ARISEAdaptiveDesign/WildThing-Collaboration/README.md

# Arise_WildThing
Controls for Wild Thing Conversion

2022-08-01 
General statement: continued changes to refine feel at "near straight for/rev"
Changed Mix Tables to 15x2 array (was 14x2 array)
Changed "StraightDwell" to "TrimAngle" - so instead of having "dwell" area close to zero, 
it now has "Trim" zone where subtle left/right will adjust faster/slower on outer/inner wheels
tuning can be made by new calibration TrimPlus and TrimMinus

2022-07-24
General statement: Mix Tuning/Redo

2022-07-21 v4.3 from v4.2
General statement: Configured motor braking for VNH5019
*ARISE_WildThing_MEGA.in0
  - Added handling for motor braking in lines 294 to 309 for both left and right motors of course
  - braking is ramped up at a rate defined by tunable parameter "BrakeRamp"
*CalibrationJoystick.h
  - Added variables BrakeL and BrakeR to keep track of how much to brake
  - Added "BrakeRamp" to control how fast to turn brakes on.

2022-07-17 v4.2 (VNH5019)
General statement: Updated documentation
*moved pulldown resistor from pin 12 to pin 13

2022-07-15 v4.2 (VNH5019) from v4.1
General statement: Needed to remove "bang" when motors change direction, so Added Zero Crossing handling
Details
* Added calibration "zeroCrossingDwell" to tune how long to keep motor off before changing direction
* Add code to ARISE_WildThing_MEGA.ino lines 180-202(ish) to keep motor off if changing direction

2022-07-14 v4.1 (VNH5019) from v4.0
General statement: Made changes to debug mix and re-tune
Details
* Changed debug.ino to allow more information on one page
* Changed Calibrations- Motor Drop Out, Dwells

2022-05-30 v4.0 (VNH5019) from v3.3 (Spark)
General statement: Reset baseline back to VNH5019 and added wiring diagrams
Details
* Added Pull Down Resistors to electrical circuit
* Updated Software with v3.3 features and tuning
* Created Diagram Wiring for Backpack
* Changed Shield wiring from JST connectors to "soldered wire to connector"
* Deleted Green "Running" LED

2022-04-13 v3.3 GT's tuning
We have V3.0 for VNH5019 motor driver, but then made updates in SPARK version (for Grant's machine) to bring up to v3.0 software (with Pot and better tether logic). We then found software improvements for low power settings and made changes (Spin & Turn were updated to have forward vs backward tuning). So we want to merge these changes back to V3.0 for VNH5019 controller.
Also we found signal drift on analog signals (switched and joysticks) so added pulldown resistors back in.

2022-04-11 Debugged wiring and added pulldown resistors to all analog inputs. Setup for SPARK controller configuration

2022-03-21 added the DualVNH5019MotorShield dual motor controller to the list of configurable motor drivers.
The wiring diagram is setup specifically for the DualVNH5019MotorShield but other motor drivers might still be used (aka , "Amazon" & SPARK) but would need wiring diagrams to be used.

This version will be integrated into a "Backpack" electronics for the Arise_WildThing dubbed v3. It is intended that 8-10 of these versions will be made.

Software improvements yet to be made include:
  * cleanup the functions & variables
  * incorporate different user interface (RF, Sip-N-Puff, 2Button, 3Button, 4Button, Nintendo controller, Phone App, Eye Gaze, etc). This would best be done by simplifying/unifying the interface so that any combination of I/O could be used.
  * AutoLearn (or procedural Learn Sequence) to calibrate Joystick Orientation
  * More Software comments would be helpful

  Further development can be made by creating our own electronics PCB but that requires Electronic Hardware Engineering beyond the current scope.
