ARISEAdaptiveDesign/WildThing-Collaboration/WildThing-Collaboration - 4.2/ARISE_WildThing_MEGA/debug.ino

///////////////////////////////////////////////////////////////////////////////////////////////////
// << DEBUG >>
///////////////////////////////////////////////////////////////////////////////////////////////////

void debug(){

//    Serial.print("joyPosX = "); Serial.print(joyPosX); Serial.print("\t");
//    Serial.print("joyPosY = "); Serial.print(joyPosY); Serial.print("\t");

//    Serial.print("joyAngle = "); Serial.print(joyAngle); Serial.print("\t");
//    Serial.print("joyRadius = "); Serial.print(joyRadius); Serial.print("\t");
//    Serial.print("scale = "); Serial.print(scale); Serial.print("\t");

    Serial.print("a= "); Serial.print(joyAngle); Serial.print("  ");
    Serial.print("s= "); Serial.print(scale); Serial.print("  ");

//    Serial.print("Lmix = "); Serial.print(Lmix); Serial.print("\t");
//    Serial.print("Rmix = "); Serial.print(Rmix); Serial.print("\t");
    Serial.print("Lm= "); Serial.print(Lmix); Serial.print("  ");
    Serial.print("Rm= "); Serial.print(Rmix); Serial.print("  ");

//    Serial.print("motorLVel = "); Serial.print(motorLVel); Serial.print("\t");
//    Serial.print("motorRVel = "); Serial.print(motorRVel); Serial.print("\t");
//    Serial.print("LV = "); Serial.print(motorLVel); Serial.print("\t");
//    Serial.print("RV = "); Serial.print(motorRVel); Serial.print("\t");


//    Serial.print("motorLVel_Filt = "); Serial.print(motorLVel_Filt); Serial.print("\t");
//    Serial.print("motorRVel_Filt = "); Serial.print(motorRVel_Filt); Serial.print("\t");
//    Serial.print("speedMultiplier = "); Serial.print(speedMultiplier); Serial.print("\t");
    Serial.print("LV_Filt = "); Serial.print(motorLVel_Filt); Serial.print("\t");
    Serial.print("RV_Filt = "); Serial.print(motorRVel_Filt); Serial.print("\t");

//    Serial.print("motorLVel_Final = "); Serial.print(motorLVel_Final); Serial.print("\t");
//    Serial.print("motorRVel_Final = "); Serial.print(motorRVel_Final); Serial.print("\t");
    Serial.print("LV_Final = "); Serial.print(motorLVel_Final); Serial.print("\t");
    Serial.print("RV_Final = "); Serial.print(motorRVel_Final); Serial.print("\t");

//    Serial.print("motorLSpeed = "); Serial.print(motorLSpeed); Serial.print("\t");
//    Serial.print("motorRSpeed = "); Serial.print(motorRSpeed); Serial.print("\t");
//    Serial.print("LSp = "); Serial.print(motorLSpeed); Serial.print("\t");
//    Serial.print("RSp = "); Serial.print(motorRSpeed); Serial.print("\t");

    //Serial.print("JoySwitch_Onboard = "); Serial.print(JoySwitch_Onboard); Serial.print("\t");
    //Serial.print("JoySwitch_Main = "); Serial.print(JoySwitch_Main); Serial.print("\t");

//    Serial.print("Left Current: "); Serial.print(md.getM1CurrentMilliamps()/1000); Serial.print("\t");
//    Serial.print("Right Current: "); Serial.println(md.getM2CurrentMilliamps()/1000);

//    Serial.println("");

//    Serial.print("VCC = "); Serial.print( readVcc(), DEC ); Serial.print("\t");
//    Serial.print("switchLow = "); Serial.print(switchLow); Serial.print("\t");
//    Serial.print("switchHigh = "); Serial.print(switchHigh); Serial.print("\t");

//    Serial.print("Level = "); Serial.print(powerLevel); Serial.print("\t");

//    Serial.print("RFor = "); Serial.print(motorRForward); Serial.print("\t");
//    Serial.print("RV_n = "); Serial.print(motorRVel_next); Serial.print("\t");
//    Serial.print("RxCnt = "); Serial.print(zeroCrossingCountR); Serial.print("\t");

//    Serial.print("LFor = "); Serial.print(motorLForward); Serial.print("\t");
//    Serial.print("LV_n = "); Serial.print(motorLVel_next); Serial.print("\t");
//    Serial.print("LxCnt = "); Serial.print(zeroCrossingCountL); Serial.print("\t");

      Serial.println("");

}
