ARISEAdaptiveDesign/WildThing-Collaboration/(commit log)

2022-06-09 Update MEGA Pinout WithMotorShield.xlsx
    Added dedicated blue +5v wire to light the LED tether switch. The combined single wire was not functioning in a stable way.
2022-07-17 Updated MEGA Pinout WithMotorShield.xlsx
    Corrected slight error in the documentation by moving one of the pulldown resistors from pin 13 to pin 12 since pin 13 is not currently being used.
    [ARISE_WildThing_MEGA.ino, CalibrationJoystick.h, CalibrationsGlobal.h, createJoystickTables.ino, debug.ino]
2022-07-21 2022-07-21 v4.3 from v4.2 General statement: Configured motor braking for VNH5019 *ARISE_WildThing_MEGA.in0 - Added handling for motor braking in lines 294 to 309 for both left and right motors of co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
2022-07-21 Fixed Typos in last commit. Code compiles now.
    [ARISE_WildThing_MEGA.ino, CalibrationJoystick.h]
2022-08-02 Changed StraightDwell into TrimAngle to give "fine control" at straight forward/reverse
    [ARISE_WildThing_MEGA.ino, CalibrationJoystick.h, CalibrationsGlobal.h, createJoystickTables.ino]
2022-08-16 Changed Orientation of Joysticks, because last version didn't have onboard setup and definition of "Front" is now modified. (Changes to Excel Doc wiring diagram will be made by tracy to show new "Fro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
    [CalibrationJoystick.h]
2022-10-10 added some lengths/dimensions to the wires in the wiring diagram
2022-10-10 added more wire lengths to wiring sketch
2022-10-20 Updated wiring diagram with more wire lengths and changed jumper wiring on shield to reflect latest changes
2022-11-03 Updated Wiring Diagram of Shield because old pinout might smoke the mega by connecting pins D42 and D43 to ground.
2022-11-14 Added wiring diagram for button control to excel sheet Fixed +/- motor polarity on M2 (Right motor)
    [CalibrationJoystick.h]
2022-11-29 Changed Motor Polarity on both Left & Right (per testing at Arise) Added Wiring layout for Optional Speed Pot
2022-12-09 Excel Documentation changes. Motor Directions
2023-06-13 Added scaling to the code
    Bill Smith added functionality which scales the speed of the device regardless of the potentiometer position. This protects from slowing the motors past their dropout point.
